Gianne97/Combline-cavity-filter-for-the-E1-Galileo-band/README.md

# Combline-cavity-filter-for-the-E1-Galileo-band
Supporting material for the publication entitled "Comparison of Inductive and Capacitive End Couplings in the Design of a Combline Microwave Cavity Filter for the E1 Galileo Band", authored by Enrico Boni, Giacomo Giannetti (corresponding author: giacomo.giannetti@unifi.it), Stefano Maddio, and Giuseppe Pelosi. The publication is available at https://ars.copernicus.org/articles/22/1/2024/ (DOI: 10.5194/ars-22-1-2024).

The following files are provided:
- technical drawings of the filters
- CST CAD models
- data plotted in the figures
