Gianne97/Combline-cavity-filter-for-the-E1-Galileo-band/TechnicalDrawings/GG0024A.pdf

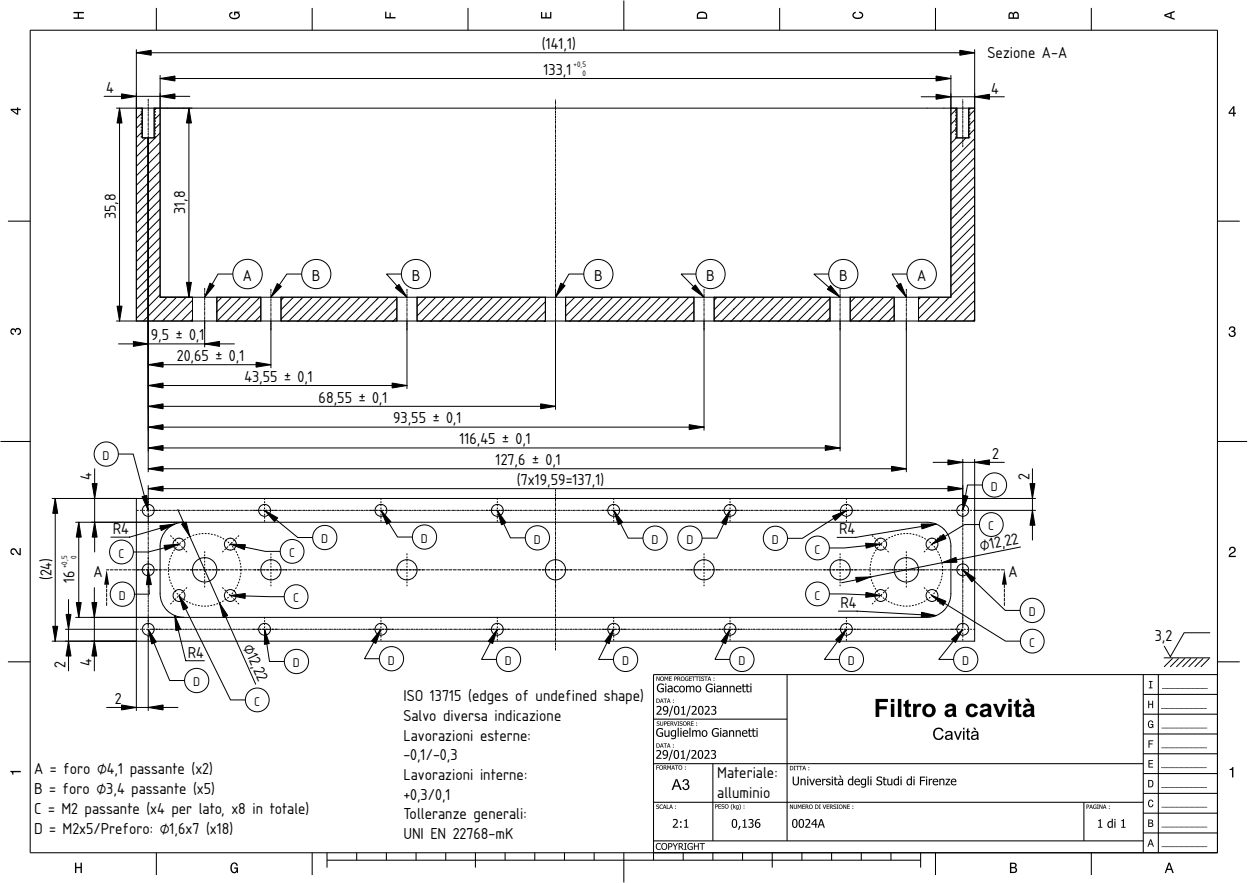
[picture p1: page 1]
Materiale:; alluminio; Sezione A-A

ISO 13715 (edges of undefined shape)
Salvo diversa indicazione
Lavorazioni esterne:
Lavorazioni interne:
Tolleranze generali:
UNI EN 22768-mK

A = foro ⌀4,1 passante (x2)
B = foro ⌀3,4 passante (x5)
C = M2 passante (x4 per lato, x8 in totale)
D = M2x5/Preforo: ⌀1,6x7 (x18)
