Gianne97/Combline-cavity-filter-for-the-E1-Galileo-band/TechnicalDrawings/GG0025B.pdf

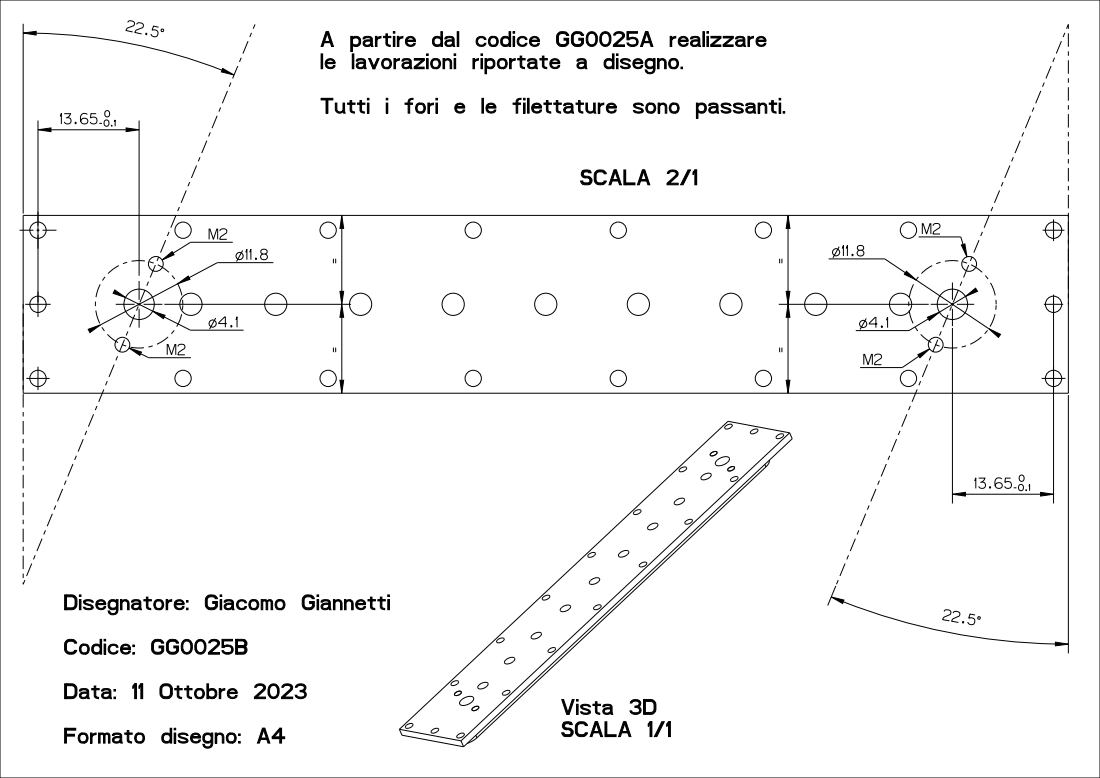
[picture p2: page 1]
Data:; 11 Ottobre 2023; lavorazioni; riportate a disegno.; Tutti; i fori e; filettature; sono passanti.; Vista 3D SCALA 1/1; SCALA 2/1

A partire dal codice GG0025A realizzare

Disegnatore: Giacomo Giannetti
Codice: GG0025B
Formato disegno: A4
