Gianne97/Combline-cavity-filter-for-the-E1-Galileo-band/TechnicalDrawings/GG0025A.pdf

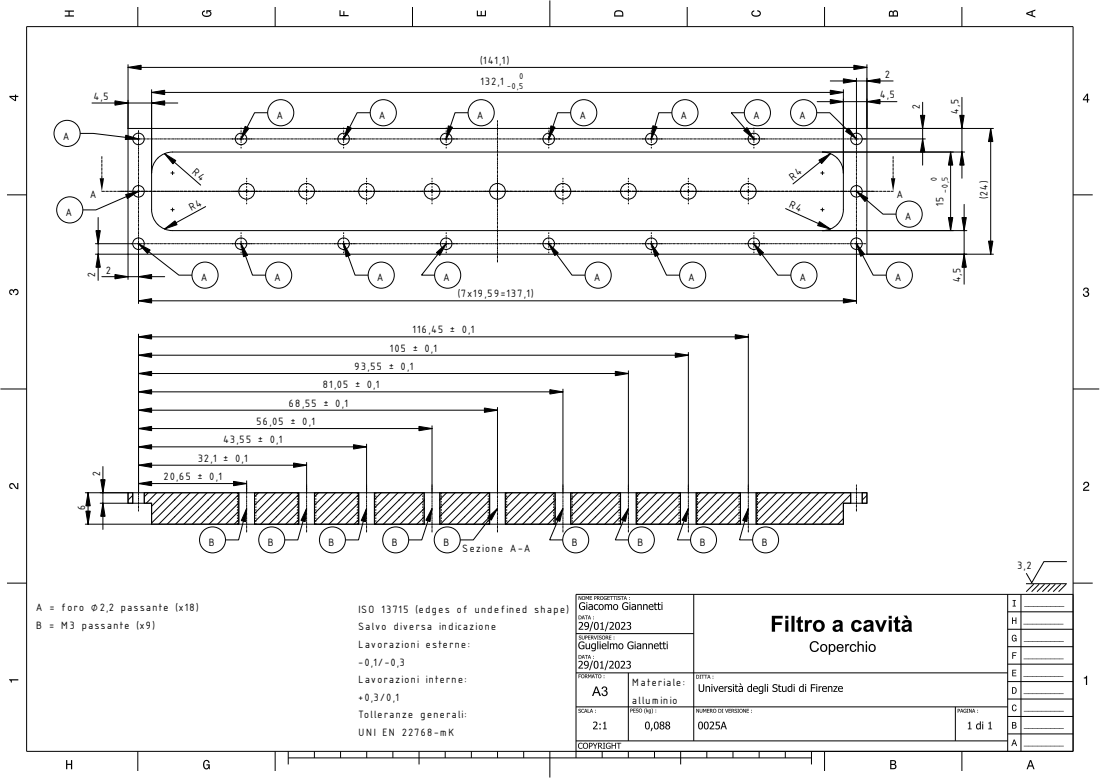
[picture p3: page 1]
S ezione A -A; A = foro ⌀ 2,2 passante (x18) B = M 3 passante (x9); M ateriale: allum inio

IS O 13715 (edges of undefined shape)
S alvo diversa indicazione
Lavorazioni esterne:
Lavorazioni interne:
Tolleranze generali:
