Gianne97/Combline-cavity-filter-for-the-E1-Galileo-band/TechnicalDrawings/GG0026A.pdf

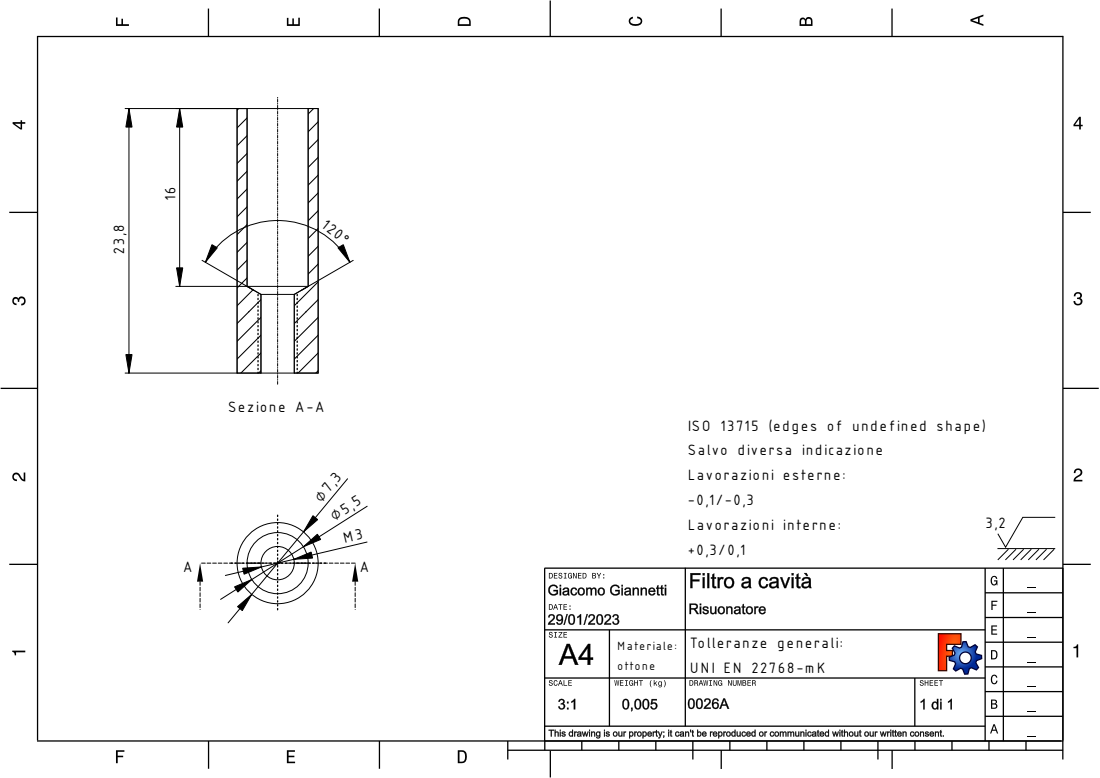
[picture p4: page 1]
S ezione A -A; Tolleranze generali: U N I E N 22768-m K; M ateriale: ottone

IS O 13715 (edges of undefined shape)
S alvo diversa indicazione
Lavorazioni esterne:
Lavorazioni interne:
