Gianne97/Combline-cavity-filter-for-the-E1-Galileo-band/TechnicalDrawings/GG0027A.pdf

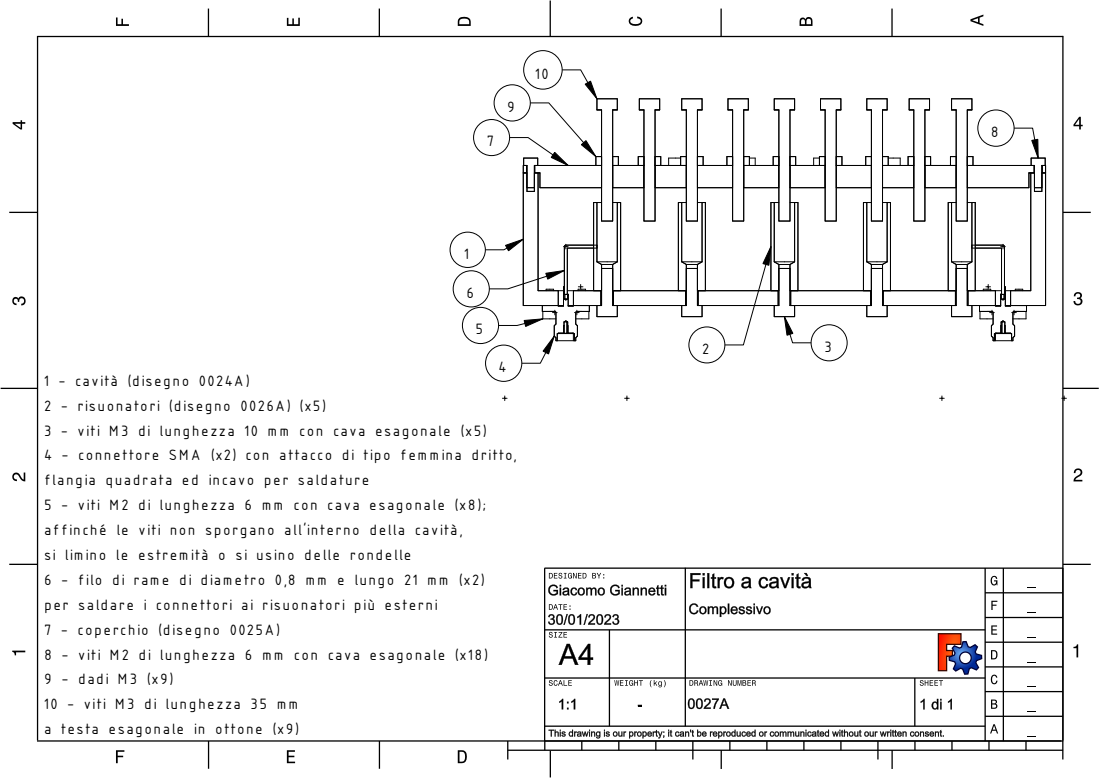
[picture p5: page 1]

1 - cavità (disegno 0024 A )
2 - risuonatori (disegno 0026 A ) (x5)
3 - viti M 3 di lunghezza 10 m m con cava esagonale (x5)
4 - connettore S M A (x2) con attacco di tipo fem m ina dritto,
flangia quadrata ed incavo per saldature
5 - viti M 2 di lunghezza 6 m m con cava esagonale (x8);
affinché le viti non sporgano all'interno della cavità,
si lim ino le estrem ità o si usino delle rondelle
6 - filo di ram e di diam etro 0,8 m m e lungo 21 m m (x2)
per saldare i connettori ai risuonatori più esterni
7 - coperchio (disegno 0025 A )
8 - viti M 2 di lunghezza 6 m m con cava esagonale (x18)
9 - dadi M 3 (x9)
10 - viti M 3 di lunghezza 35 m m
a testa esagonale in ottone (x9)
